anybuche/bitaxeGamma/bitaxeGamma.kicad_pcb

## KiCad design bitaxeGamma.kicad_pcb (2025-08-15)

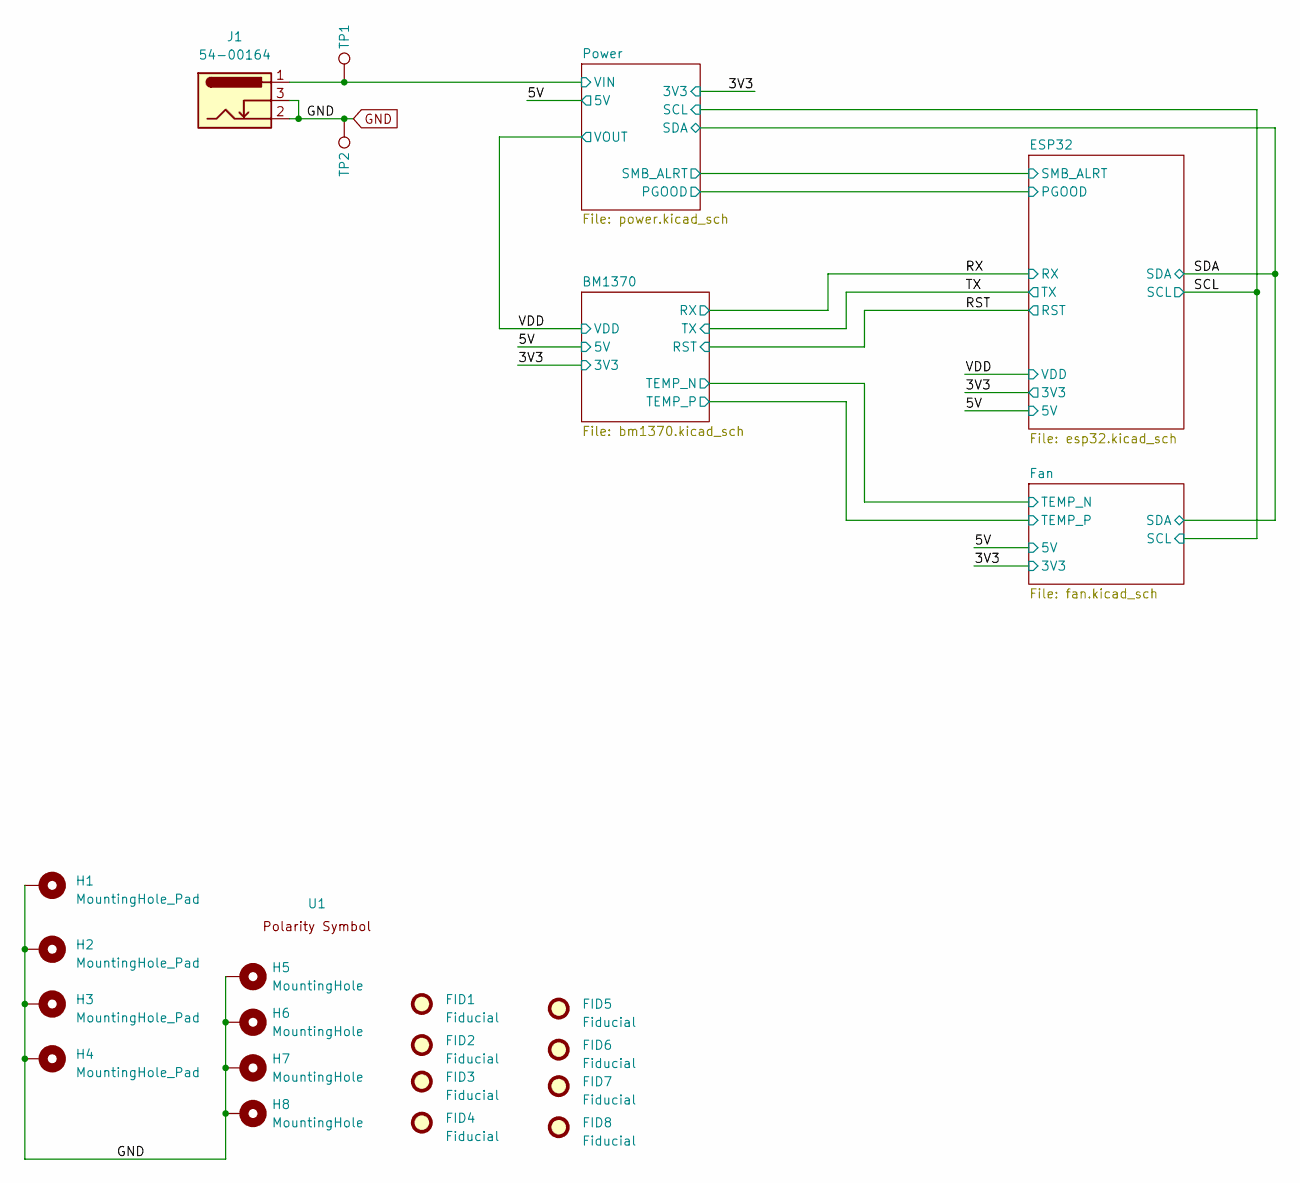
[picture p1: schematic bitaxeGamma.kicad_sch]

Parts:
FID1, FID2, FID3, FID4, FID5, FID6, FID7, FID8: Fiducial; Fiducial_1mm_Mask2mm
H1, H2, H3, H4: MountingHole_Pad; MountingHole_3mm_Pad_Via
H5, H6, H7, H8: MountingHole; MountingHole_3mm_Pad
J1: 54-00164; TENSILITY_54-00164; MPN 54-00164; LCSC C431534
TP1, TP2: TestPoint; TestPoint_Pad_D1.5mm
U1: polarity

Connections:
/5V: J1.1, TP1.1; also elsewhere on the board

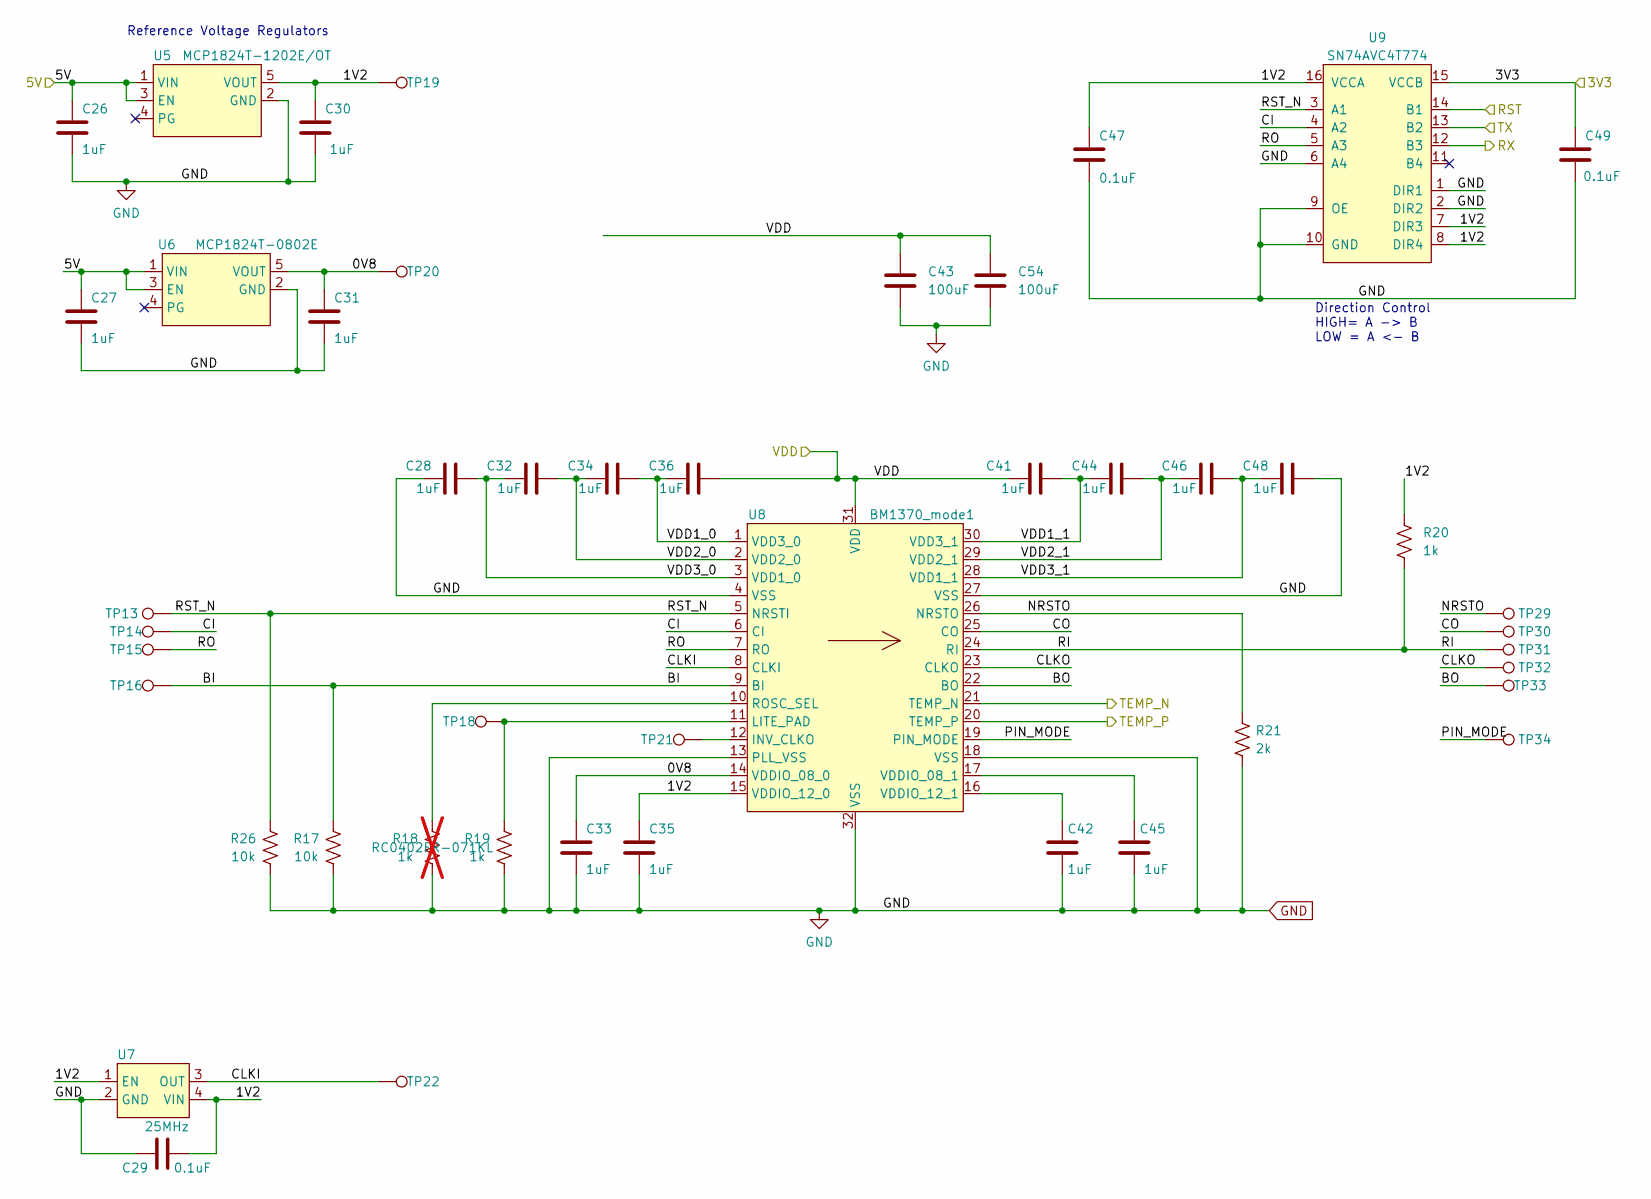
[picture p2: schematic bm1370.kicad_sch, bitaxeGamma]

Parts:
C26, C27, C28, C30, C31, C32, C33, C34, C35, C36, C41, C42, C44, C45, C46, C48: 1uF; C_0402_1005Metric; MPN EMK105BJ105MV-F
C29, C47, C49: 0.1uF; C_0402_1005Metric; MPN CL05A104KO5NNNC
C43, C54: 100uF; C_1206_3216Metric; MPN CL31A107MQHNNNE
R17, R26: 10k; R_0402_1005Metric; MPN RC0402FR-0710KL
R18: 1k; R_0402_1005Metric; MPN RC0402FR-071KL; not fitted
R19, R20: 1k; R_0402_1005Metric; MPN RC0402FR-071KL
R21: 2k; R_0402_1005Metric; MPN RC0402FR-072KL
TP13, TP14, TP15, TP16, TP18, TP19, TP20, TP21, TP22, TP29, TP30, TP31, TP32, TP33, TP34: TestPoint; TestPoint_Pad_D1.5mm
U5: MCP1824T-1202E/OT; SOT-23-5; MPN MCP1824T-1202E/OT
U6: MCP1824T-0802E; SOT-23-5; MPN MCP1824T-0802E/OT
U7: 25MHz; SMD3225-4P; MPN SX3M25.000E20F30THN; LCSC C5137262
U8: BM1370_mode1; BM1370
U9: SN74AVC4T774; TSSOP-16_4.4x5mm_P0.65mm; MPN SN74AVC4T774PWR

Connections:
/3V3: C49.1, U9.15 (VCCB); also elsewhere on the board
/5V: C26.1, C27.1, U5.1 (VIN), U5.3 (EN), U6.1 (VIN), U6.3 (EN); also elsewhere on the board
/BM1370/0V8: C31.1, C33.1, TP20.1, U6.5 (VOUT), U8.14 (VDDIO_08_0)
/BM1370/1V2: C29.2, C30.1, C35.1, C47.1, R20.1, TP19.1, U5.5 (VOUT), U7.1 (EN), U7.4 (VIN), U8.15 (VDDIO_12_0), U9.7 (DIR3), U9.8 (DIR4), U9.16 (VCCA)
/BM1370/BI: R17.2, TP16.1, U8.9 (BI)
/BM1370/BO: TP33.1, U8.22 (BO)
/BM1370/CI: TP14.1, U8.6 (CI), U9.4 (A2)
/BM1370/CLKI: TP22.1, U7.3 (OUT), U8.8 (CLKI)
/BM1370/CLKO: TP32.1, U8.23 (CLKO)
/BM1370/CO: TP30.1, U8.25 (CO)
/BM1370/NRSTO: R21.1, TP29.1, U8.26 (NRSTO)
/BM1370/PIN_MODE: TP34.1, U8.19 (PIN_MODE)
/BM1370/RI: R20.2, TP31.1, U8.24 (RI)
/BM1370/RO: TP15.1, U8.7 (RO), U9.5 (A3)
/BM1370/RST_N: R26.2, TP13.1, U8.5 (NRSTI), U9.3 (A1)
/BM1370/VDD1_0: C34.2, C36.1, U8.1 (VDD3_0)
/BM1370/VDD1_1: C41.2, C44.1, U8.30 (VDD3_1)
/BM1370/VDD2_0: C32.2, C34.1, U8.2 (VDD2_0)
/BM1370/VDD2_1: C44.2, C46.1, U8.29 (VDD2_1)
/BM1370/VDD3_0: C28.2, C32.1, U8.3 (VDD1_0)
/BM1370/VDD3_1: C46.2, C48.1, U8.28 (VDD1_1)
/Fan/TEMP_N: U8.21 (TEMP_N); also elsewhere on the board
/Fan/TEMP_P: U8.20 (TEMP_P); also elsewhere on the board
/RST: U9.14 (B1); also elsewhere on the board
/RX: U9.12 (B3); also elsewhere on the board
/TX: U9.13 (B2); also elsewhere on the board
/VDD: C36.2, C41.1, C43.1, C54.1, U8.31 (VDD); also elsewhere on the board
unnamed: TP21.1, U8.12 (INV_CLKO)
unnamed: R19.2, TP18.1, U8.11 (LITE_PAD)
unnamed: C45.1, U8.17 (VDDIO_08_1)
unnamed: C42.1, U8.16 (VDDIO_12_1)

Notes on the sheet:
Reference Voltage Regulators
Direction Control HIGH= A -> B LOW = A <- B

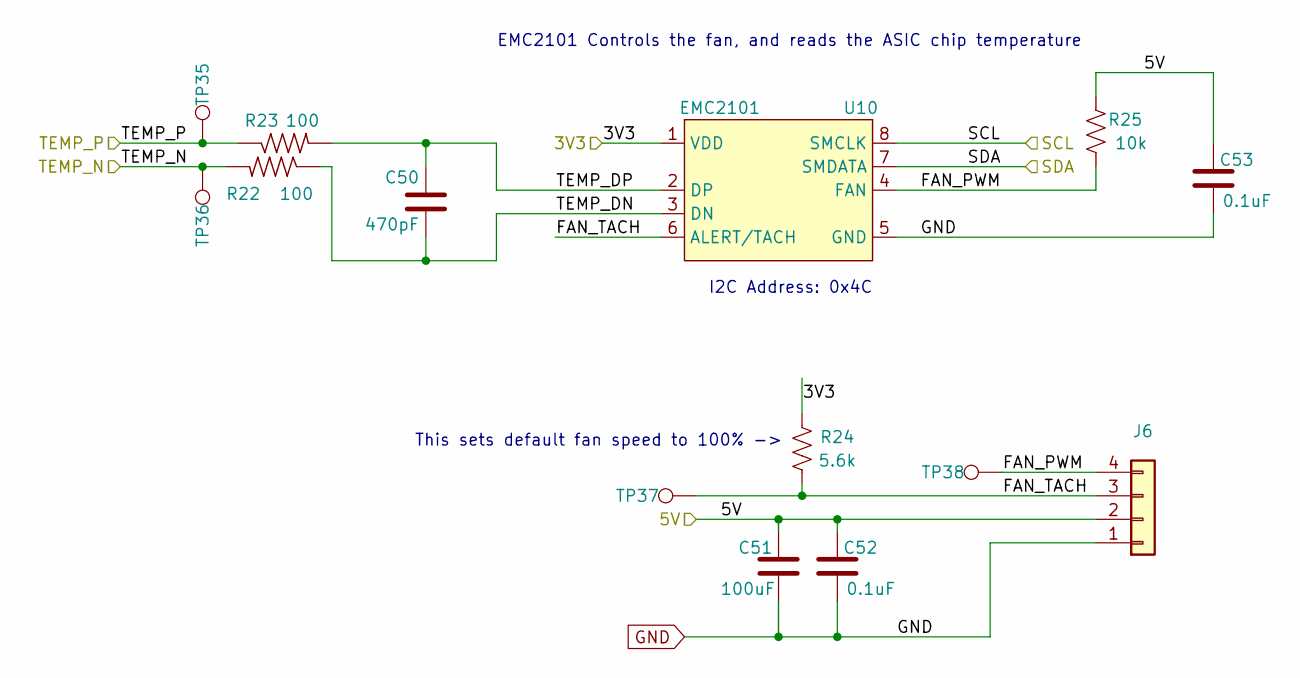
[picture p3: schematic fan.kicad_sch, bitaxeGamma]

Parts:
C50: 470pF; C_0402_1005Metric; MPN CL05B471KB5NNNC
C51: 100uF; C_1206_3216Metric; MPN CL31A107MQHNNNE
C52, C53: 0.1uF; C_0402_1005Metric; MPN CL05A104KO5NNNC
J6: Conn_01x04; 470531000; MPN 0470531000
R22, R23: 100; R_0402_1005Metric; MPN RC0402FR-07100RL
R24: 5.6k; R_0402_1005Metric; MPN RC0402FR-135K6L
R25: 10k; R_0402_1005Metric; MPN RC0402FR-0710KL
TP35, TP36, TP37, TP38: TestPoint; TestPoint_Pad_D1.5mm
U10: EMC2101; TSSOP-8_3x3mm_P0.65mm; MPN EMC2101-R-ACZL-TR

Connections:
/3V3: R24.2, U10.1 (VDD); also elsewhere on the board
/5V: C51.1, C52.1, C53.1, J6.2, R25.2; also elsewhere on the board
/Fan/FAN_PWM: J6.4, R25.1, TP38.1, U10.4 (FAN)
/Fan/FAN_TACH: J6.3, R24.1, TP37.1, U10.6 (ALERT/TACH)
/Fan/TEMP_DN: C50.2, R22.1, U10.3 (DN)
/Fan/TEMP_DP: C50.1, R23.2, U10.2 (DP)
/Fan/TEMP_N: R22.2, TP36.1; also elsewhere on the board
/Fan/TEMP_P: R23.1, TP35.1; also elsewhere on the board
/SCL: U10.8 (SMCLK); also elsewhere on the board
/SDA: U10.7 (SMDATA); also elsewhere on the board

Notes on the sheet:
EMC2101 Controls the fan, and reads the ASIC chip temperature
This sets default fan speed to 100% ->
I2C Address: 0x4C

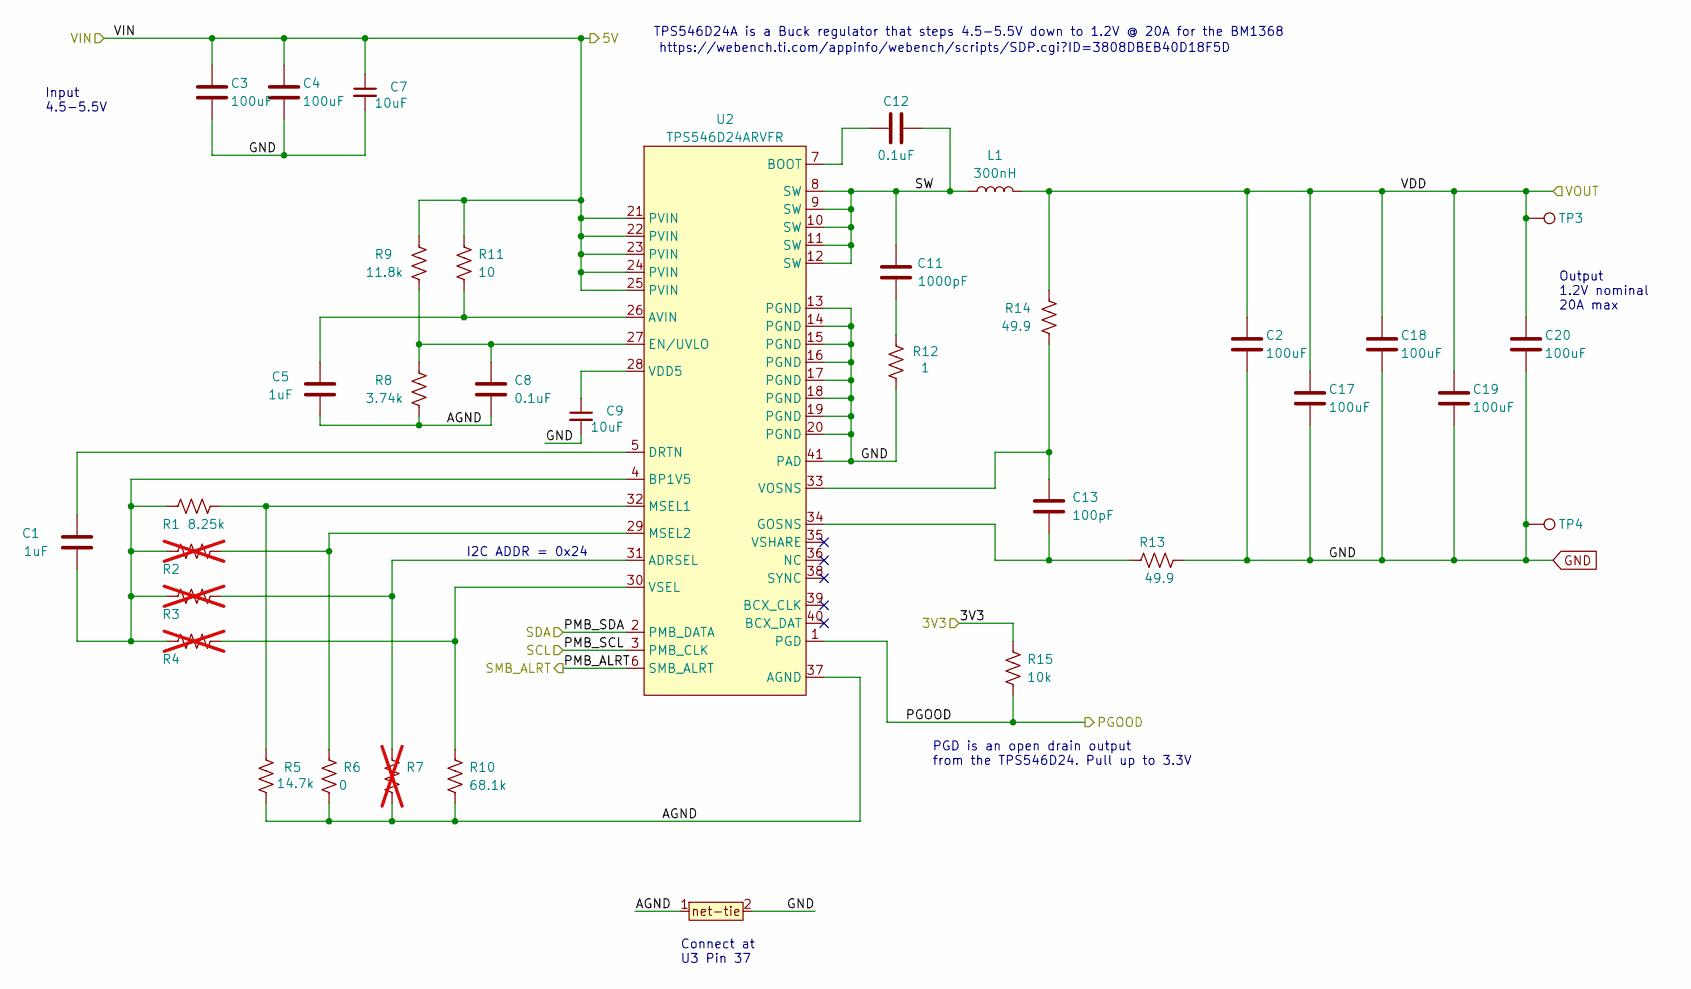
[picture p4: schematic power.kicad_sch, bitaxeGamma]

Parts:
C1, C5: 1uF; C_0402_1005Metric; MPN EMK105BJ105MV-F
C2, C3, C4, C17, C18, C19, C20: 100uF; C_1206_3216Metric; MPN CL31A107MQHNNNE
C7, C9: 10uF; C_0603_1608Metric; MPN GRM188R61E106KA73D
C8, C12: 0.1uF; C_0402_1005Metric; MPN CL05A104KO5NNNC
C11: 1000pF; C_0805_2012Metric; MPN CC0805KRX7R9BB102
C13: 100pF; C_0402_1005Metric; MPN 885012005013
L1: 300nH; SLC1175-271MEC_COC; MPN 744308033
R1: 8.25k; R_0402_1005Metric; MPN RC0402FR-078K25L
R2, R3, R4, R7: R_0402_1005Metric; not fitted
R5: 14.7k; R_0402_1005Metric; MPN RC0402FR-0714K7L
R6: 0; R_0402_1005Metric; MPN RC0402FR-070RL
R8: 3.74k; R_0402_1005Metric; MPN RC0402FR-073K74L
R9: 11.8k; R_0402_1005Metric; MPN RC0402FR-0711K8L
R10: 68.1k; R_0402_1005Metric; MPN RC0402FR-0768K1L
R11: 10; R_0402_1005Metric; MPN RC0402FR-0710RL
R12: 1; R_1206_3216Metric; MPN CSR1206FT1R00
R13, R14: 49.9; R_0402_1005Metric; MPN RC0402FR-0749R9L
R15: 10k; R_0402_1005Metric; MPN RC0402FR-0710KL
T1: net-tie; NetTie-0.25mm; MPN 2R5TPE220MAFB
TP3, TP4: TestPoint; TestPoint_Pad_D1.5mm
U2: TPS546D24ARVFR; LQFN40-CLIP; MPN TPS546D24ARVFR

Connections:
/3V3: R15.2; also elsewhere on the board
/5V: C3.1, C4.1, C7.1, R9.1, R11.1, U2.21 (PVIN), U2.22 (PVIN), U2.23 (PVIN), U2.24 (PVIN), U2.25 (PVIN); also elsewhere on the board
/Power/PGOOD: R15.1, U2.1 (PGD); also elsewhere on the board
/Power/PMB_ALRT: U2.6 (SMB_ALRT); also elsewhere on the board
/Power/SW: C11.2, C12.2, L1.1, U2.8 (SW), U2.9 (SW), U2.10 (SW), U2.11 (SW), U2.12 (SW)
/SCL: U2.3 (PMB_CLK); also elsewhere on the board
/SDA: U2.2 (PMB_DATA); also elsewhere on the board
/VDD: C2.1, C17.1, C18.1, C19.1, C20.1, L1.2, R14.1, TP3.1; also elsewhere on the board
unnamed: C11.1, R12.2
unnamed: R3.2, R7.1, U2.31 (ADRSEL)
unnamed: C5.2, R11.2, U2.26 (AVIN)
unnamed: C12.1, U2.7 (BOOT)
unnamed: C1.2, R1.1, R2.1, R3.1, R4.1, U2.4 (BP1V5)
unnamed: C1.1, U2.5 (DRTN)
unnamed: C8.1, R8.1, R9.2, U2.27 (EN/UVLO)
unnamed: C13.2, R13.1, U2.34 (GOSNS)
unnamed: R1.2, R5.2, U2.32 (MSEL1)
unnamed: C9.1, U2.28 (VDD5)
unnamed: C13.1, R14.2, U2.33 (VOSNS)
unnamed: R4.2, R10.1, U2.30 (VSEL)

Notes on the sheet:
TPS546D24A is a Buck regulator that steps 4.5-5.5V down to 1.2V @ 20A for the BM1368
https://webench.ti.com/appinfo/webench/scripts/SDP.cgi?ID=3808DBEB40D18F5D
Input 4.5-5.5V
PGD is an open drain output from the TPS546D24. Pull up to 3.3V
I2C ADDR = 0x24
Output 1.2V nominal 20A max
Connect at U3 Pin 37

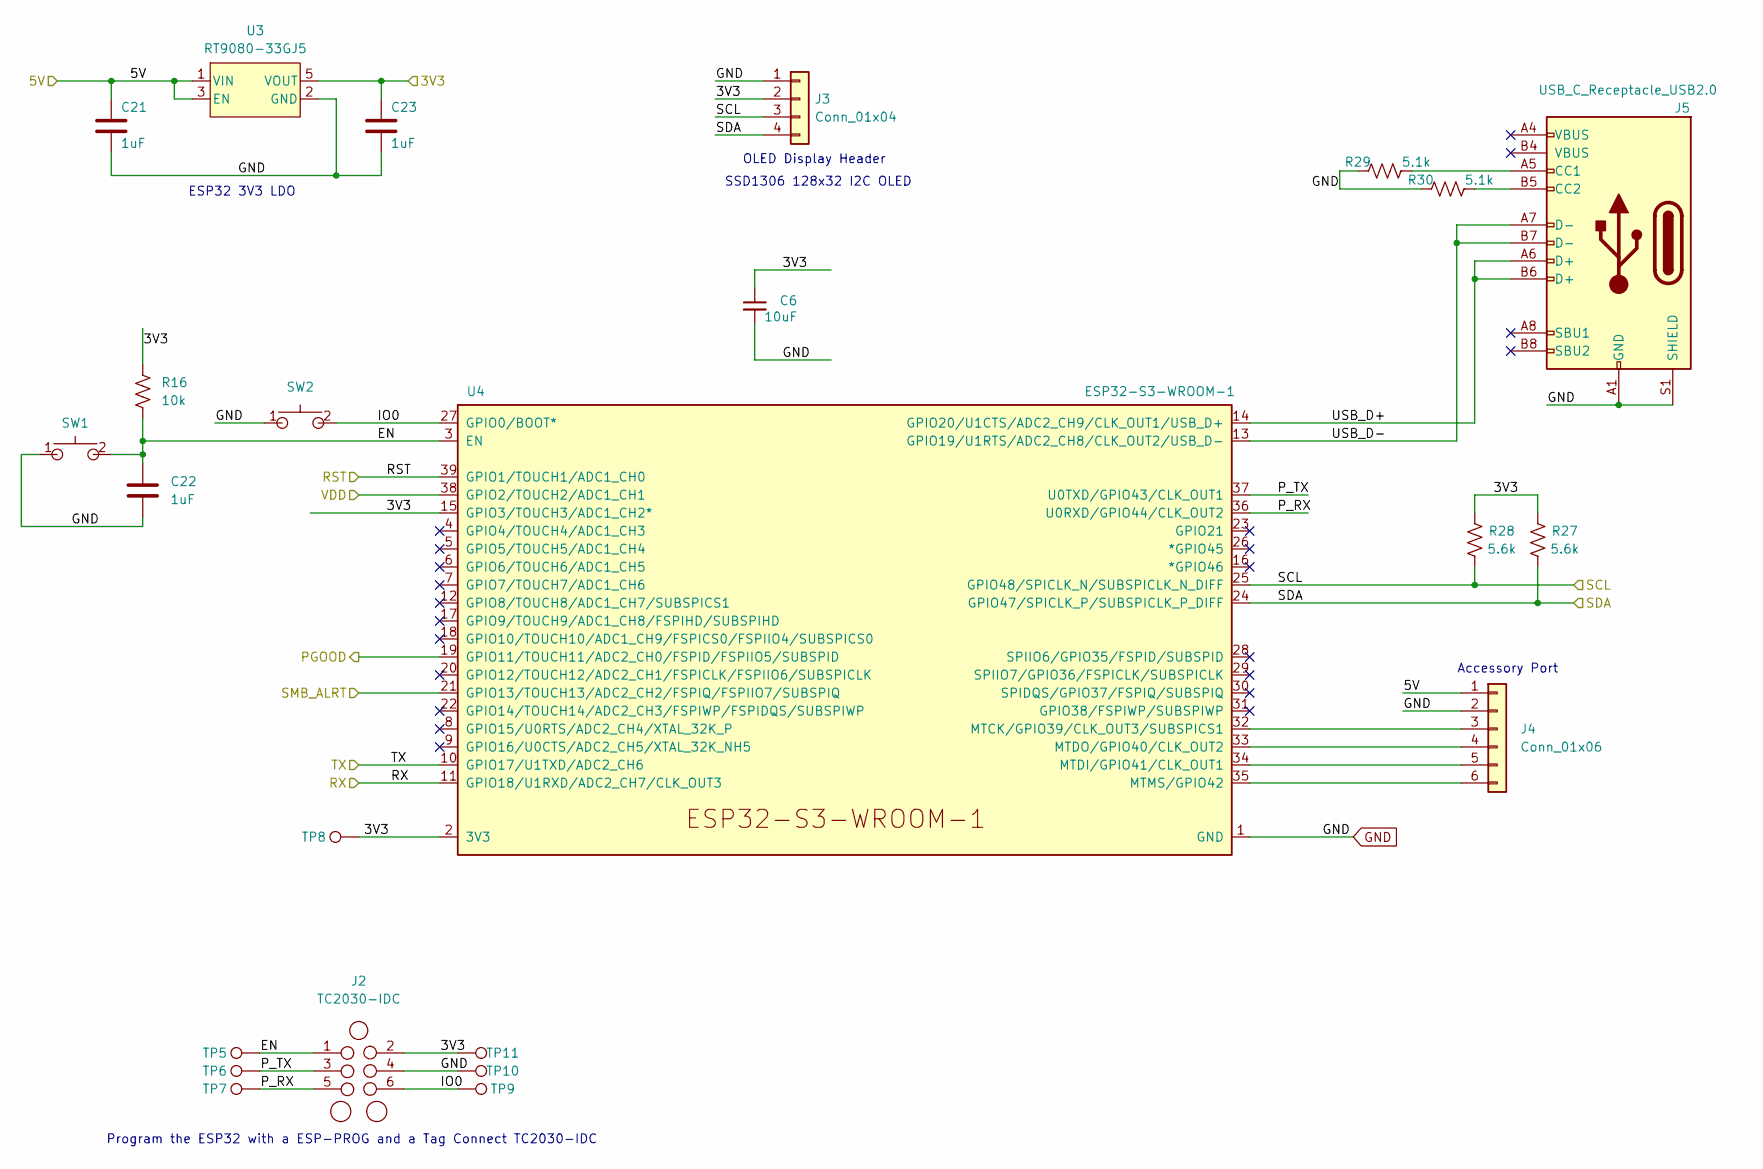
[picture p5: schematic esp32.kicad_sch, bitaxeGamma]

Parts:
C6: 10uF; C_0603_1608Metric; MPN GRM188R61E106KA73D
C21, C22, C23: 1uF; C_0402_1005Metric; MPN EMK105BJ105MV-F
J2: TC2030-IDC; Tag-Connect_TC2030-IDC-NL_2x03_P1.27mm_Vertical
J3: Conn_01x04; PinHeader_1x04_P2.54mm_Vertical_shifted
J4: Conn_01x06; PinHeader_1x06_P2.54mm_Vertical
J5: USB_C_Receptacle_USB2.0; USB_C_Receptacle_GCT_USB4105-xx-A; MPN USB4105-GF-A
R16: 10k; R_0402_1005Metric; MPN RC0402FR-0710KL
R27, R28: 5.6k; R_0402_1005Metric; MPN RC0402FR-135K6L
R29, R30: 5.1k; R_0402_1005Metric; MPN RC0402FR-075K1L; LCSC C25905
SW1, SW2: GT-TC029B-H025-L1N; SW_CS1213AGF260_CRS; MPN CS1213AGF260
TP5, TP6, TP7, TP9, TP10, TP11: TestPoint; TestPoint_Pad_D2.5mm
TP8: TestPoint; TestPoint_Pad_D1.5mm
U3: RT9080-33GJ5; MPN RT9080-33GJ5
U4: ESP32-S3-WROOM-1; MPN ESP32-S3-WROOM-1-N16R8

Connections:
/3V3: C6.1, C23.1, J2.2, J3.2, R16.1, R27.2, R28.2, TP8.1, TP11.1, U3.5 (VOUT), U4.2 (3V3), U4.15 (GPIO3/TOUCH3/ADC1_CH2*); also elsewhere on the board
/5V: C21.1, J4.1, U3.1 (VIN), U3.3 (EN); also elsewhere on the board
/ESP32/EN: C22.1, J2.1, R16.2, SW1.2, TP5.1, U4.3 (EN)
/ESP32/IO0: J2.6, SW2.2, TP9.1, U4.27 (GPIO0/BOOT*)
/ESP32/P_RX: J2.5, TP7.1, U4.36 (U0RXD/GPIO44/CLK_OUT2)
/ESP32/P_TX: J2.3, TP6.1, U4.37 (U0TXD/GPIO43/CLK_OUT1)
/ESP32/USB_D+: J5.A6 (D+), J5.B6 (D+), U4.14 (GPIO20/U1CTS/ADC2_CH9/CLK_OUT1/USB_D+)
/ESP32/USB_D-: J5.A7 (D-), J5.B7 (D-), U4.13 (GPIO19/U1RTS/ADC2_CH8/CLK_OUT2/USB_D-)
/Power/PGOOD: U4.19 (GPIO11/TOUCH11/ADC2_CH0/FSPID/FSPIIO5/S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); also elsewhere on the board
/Power/PMB_ALRT: U4.21 (GPIO13/TOUCH13/ADC2_CH2/FSPIQ/FSPIIO7/S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); also elsewhere on the board
/RST: U4.39 (GPIO1/TOUCH1/ADC1_CH0); also elsewhere on the board
/RX: U4.11 (GPIO18/U1RXD/ADC2_CH7/CLK_OUT3); also elsewhere on the board
/SCL: J3.3, R28.1, U4.25 (GPIO48/SPICLK_N/SUBSPICLK_N_DIFF); also elsewhere on the board
/SDA: J3.4, R27.1, U4.24 (GPIO47/SPICLK_P/SUBSPICLK_P_DIFF); also elsewhere on the board
/TX: U4.10 (GPIO17/U1TXD/ADC2_CH6); also elsewhere on the board
/VDD: U4.38 (GPIO2/TOUCH2/ADC1_CH1); also elsewhere on the board
unnamed: J4.3, U4.32 (MTCK/GPIO39/CLK_OUT3/SUBSPICS1)
unnamed: J4.4, U4.33 (MTDO/GPIO40/CLK_OUT2)
unnamed: J4.5, U4.34 (MTDI/GPIO41/CLK_OUT1)
unnamed: J4.6, U4.35 (MTMS/GPIO42)
unnamed: J5.A5 (CC1), R29.2
unnamed: J5.B5 (CC2), R30.2

Notes on the sheet:
Accessory Port
ESP32 3V3 LDO
Program the ESP32 with a ESP-PROG and a Tag Connect TC2030-IDC
SSD1306 128x32 I2C OLED
OLED Display Header

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
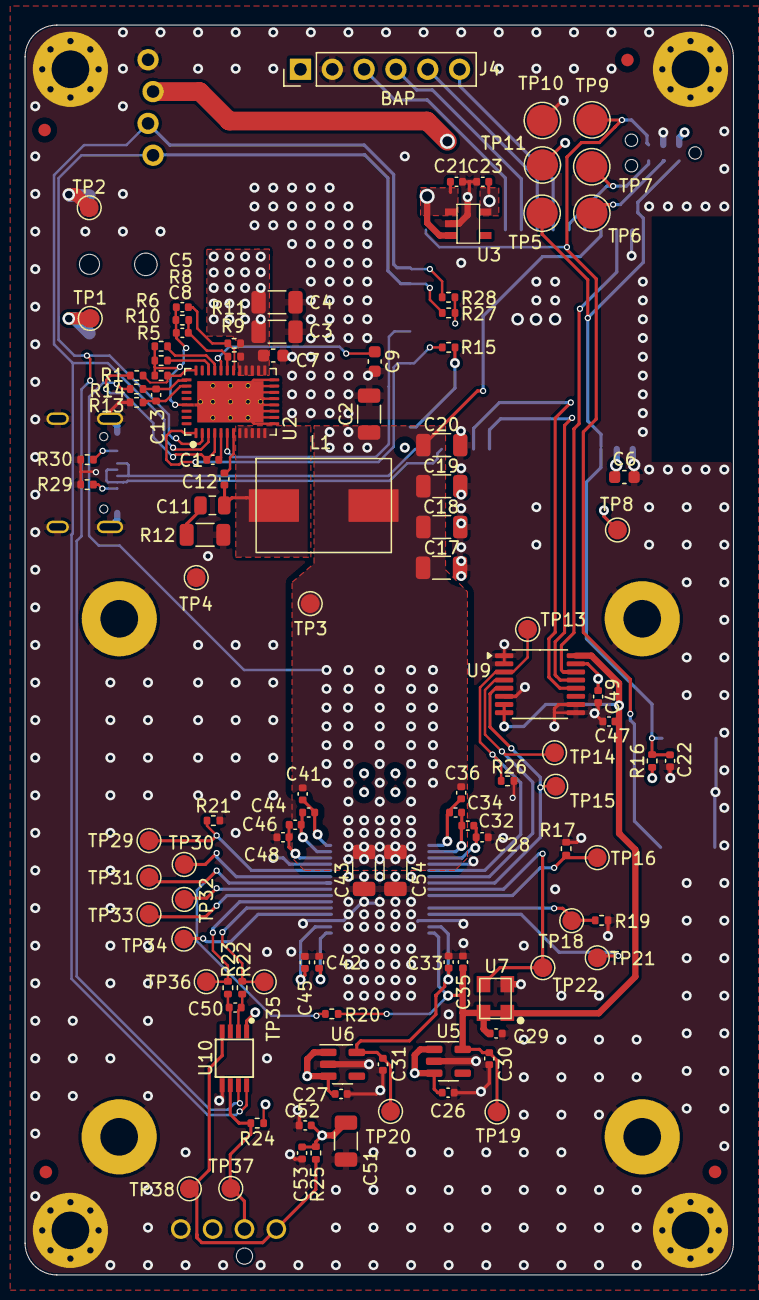
[picture p6: board bitaxeGamma.kicad_pcb from above]

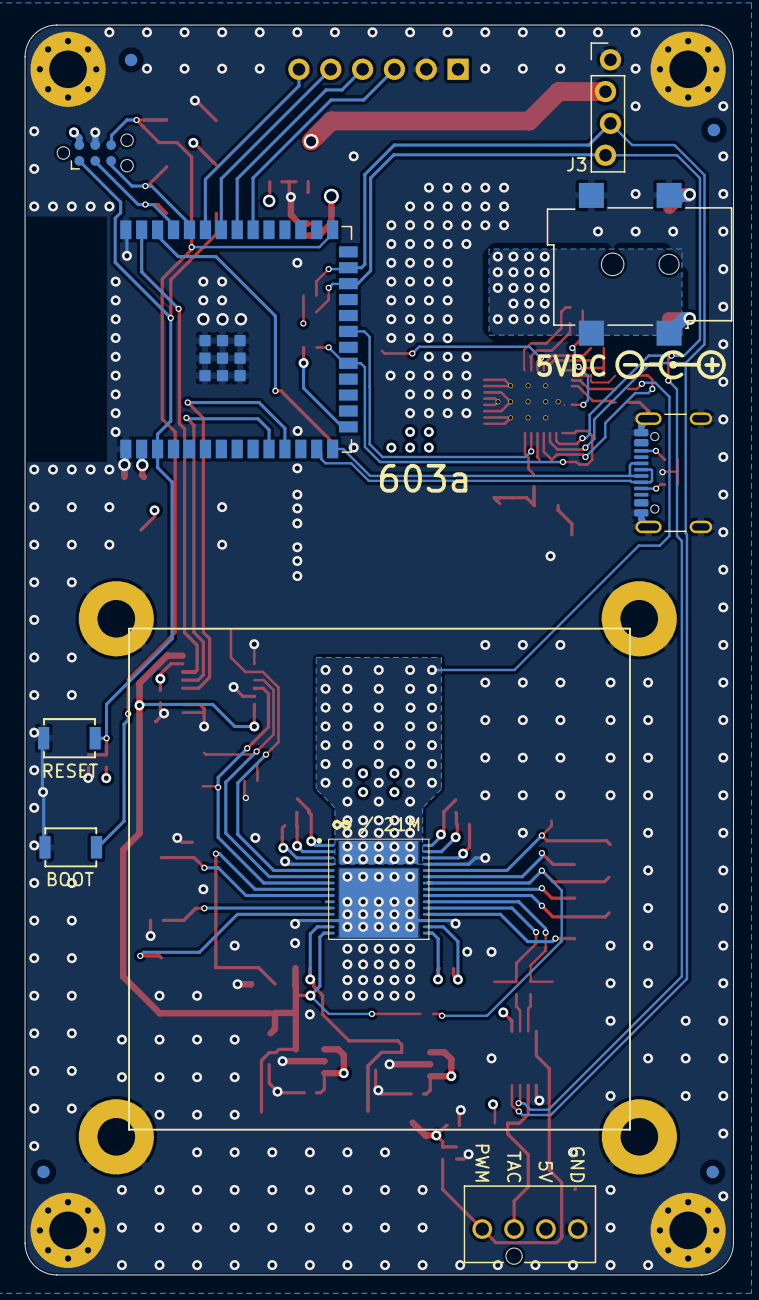
[picture p7: board bitaxeGamma.kicad_pcb from below]

Board: 4 copper layers, 56.5 x 99.8 mm, 135 parts (14 on the bottom side), 66 nets.
