anybuche/bitaxeGamma/(commit log)

2025-08-07 Optimize copper pours and routing
    [bitaxeGamma.kicad_pcb]
2025-08-10 Alin vias and components on the grid
    [bitaxeGamma.kicad_pcb]
2025-08-10 Add stitching GND vias
    [bitaxeGamma.kicad_pcb]
2025-08-15 Finish retouches and prepare manufacturing files
    [bitaxeGamma-BOM.csv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]
2025-08-15 Correct 2 zones
    [bitaxeGamma-B_Cu.gbr, bitaxeGamma-B_Mask.gbr, bitaxeGamma-B_Paste.gbr, bitaxeGamma-B_Silkscreen.gbr, bitaxeGamma-Edge_Cuts.gbr, bitaxeGamma-F_Cu.gbr, bitaxeGamma-F_Mask.gbr, bitaxeGamma-F_Paste.gbr]
